stefandanila/AquariumController/CircuitSchematics_updated.png

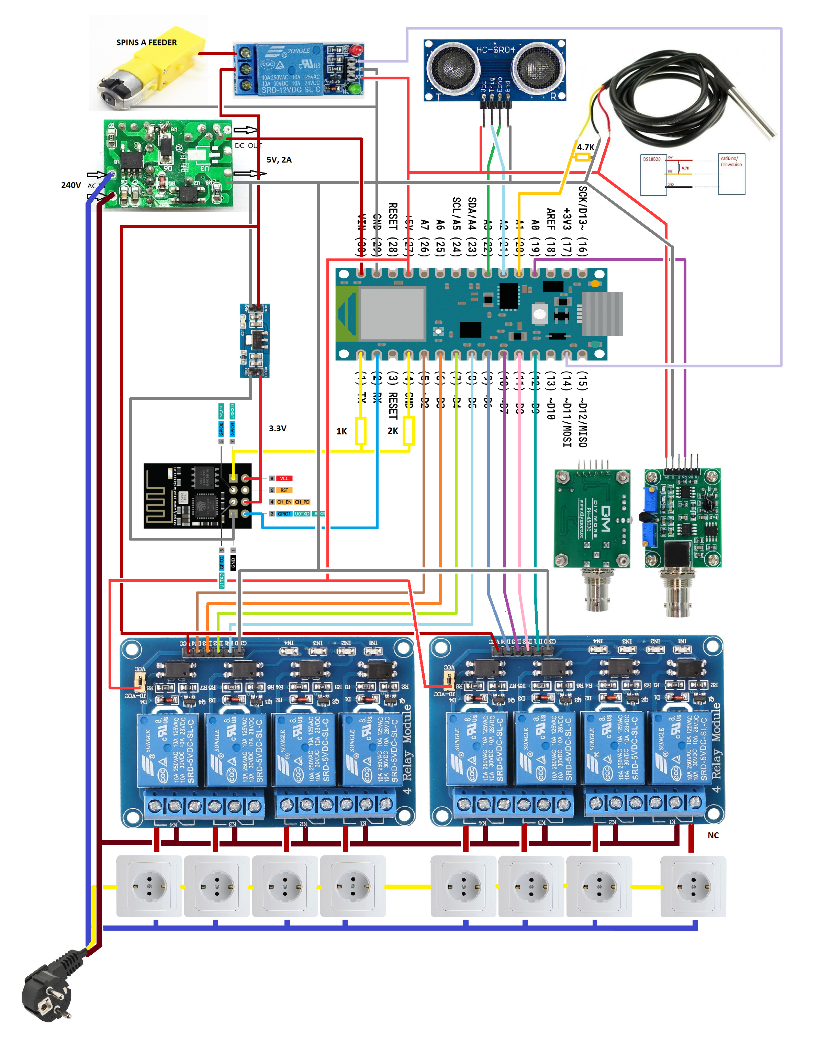
CircuitSchematics_updated.png
