stefandanila/AquariumController/HarwareExample.jpg

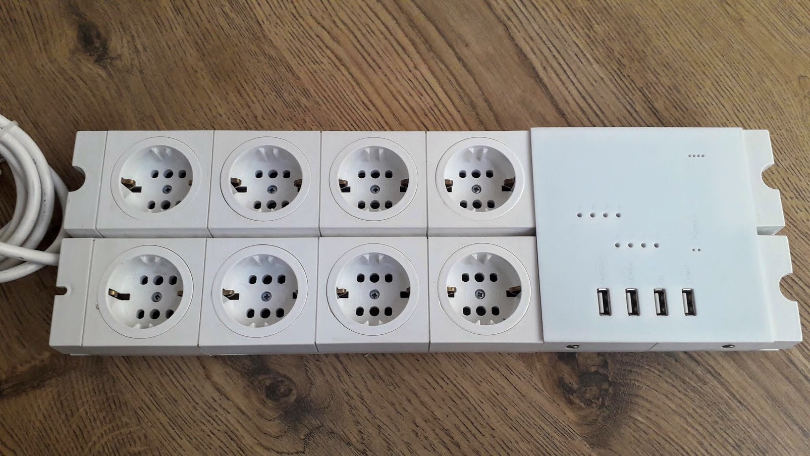
HarwareExample.jpg
