stefandanila/AquariumController/UI_Events.jpg

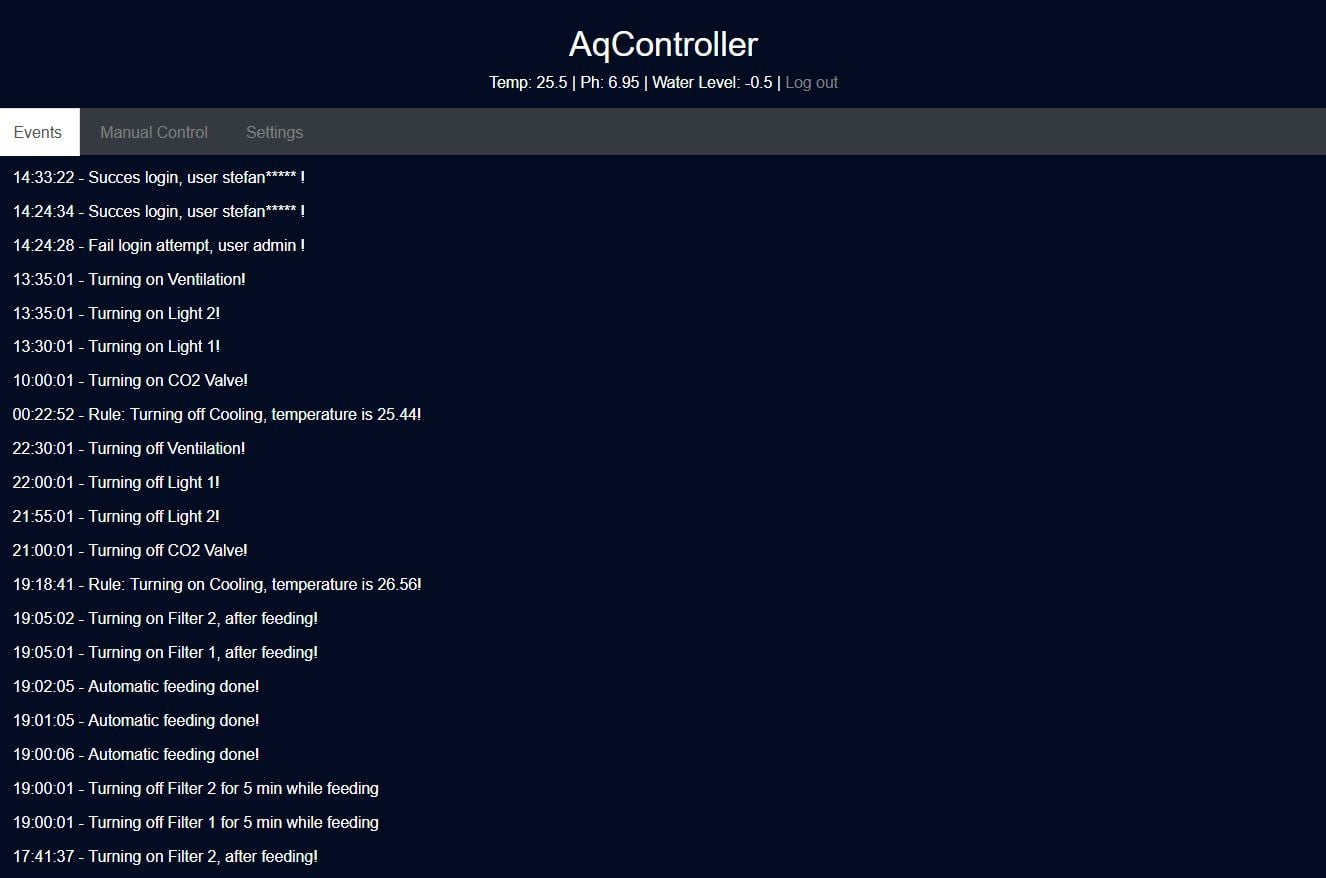
UI_Events.jpg
