stefandanila/AquariumController/UI_GeneralSettings.jpg

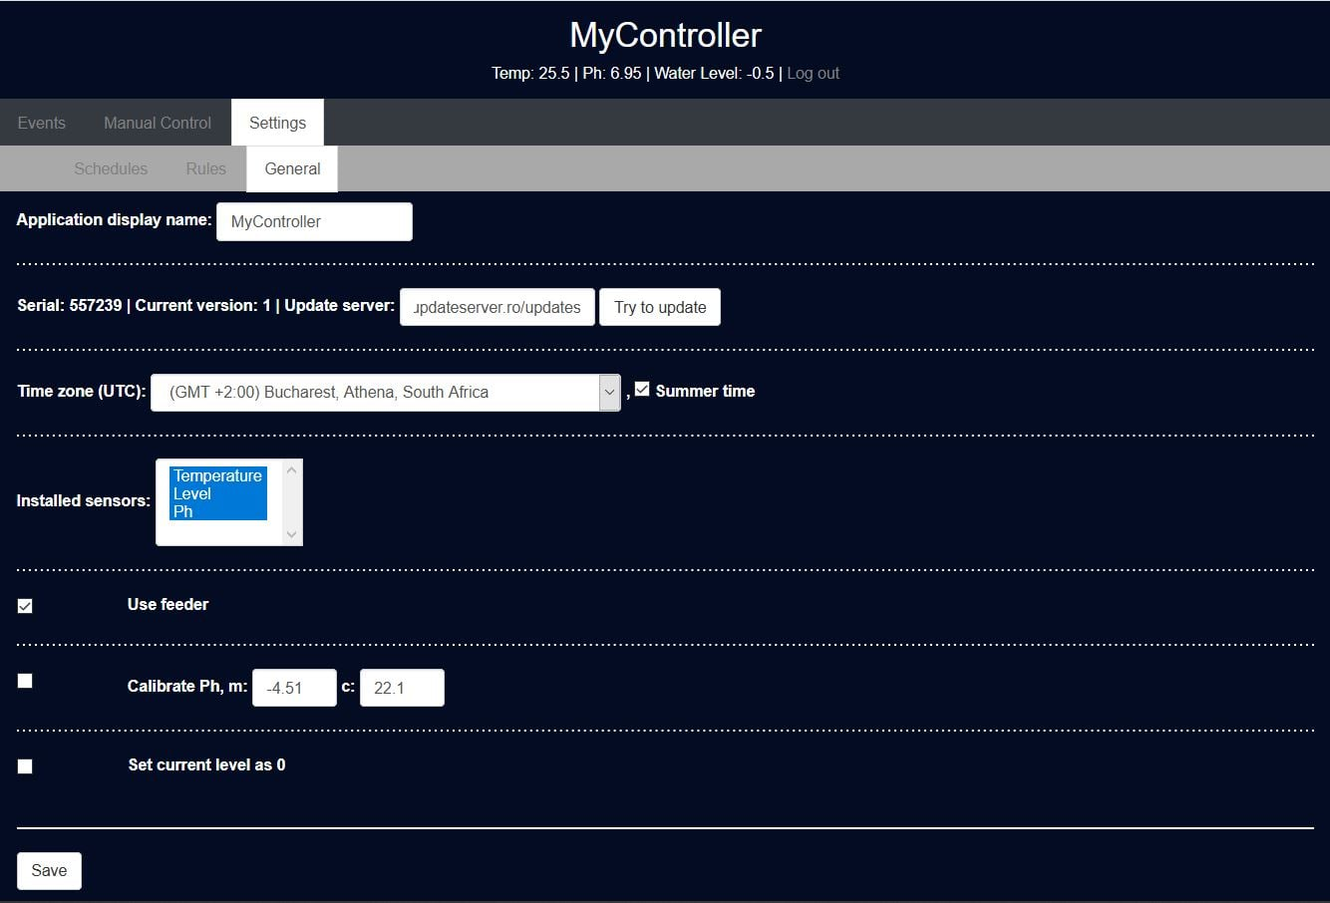
UI_GeneralSettings.jpg
