stefandanila/AquariumController/UI_Login.jpg

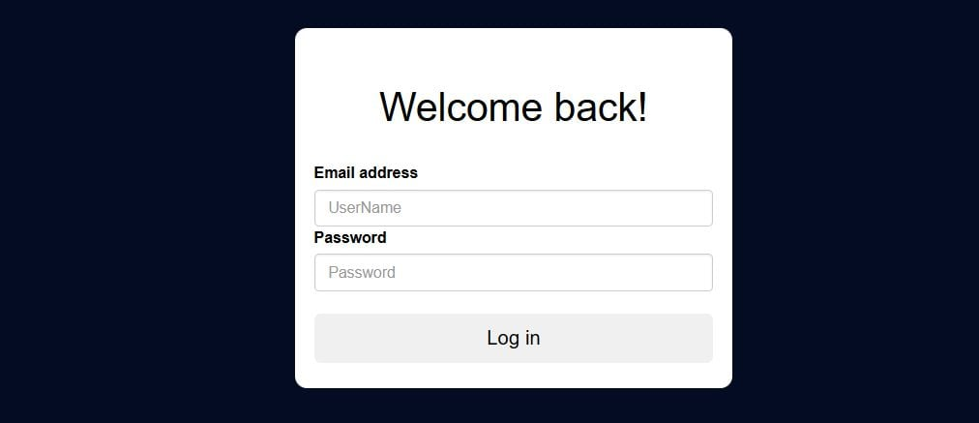
UI_Login.jpg
