stefandanila/AquariumController/UI_NetworkConf.jpg

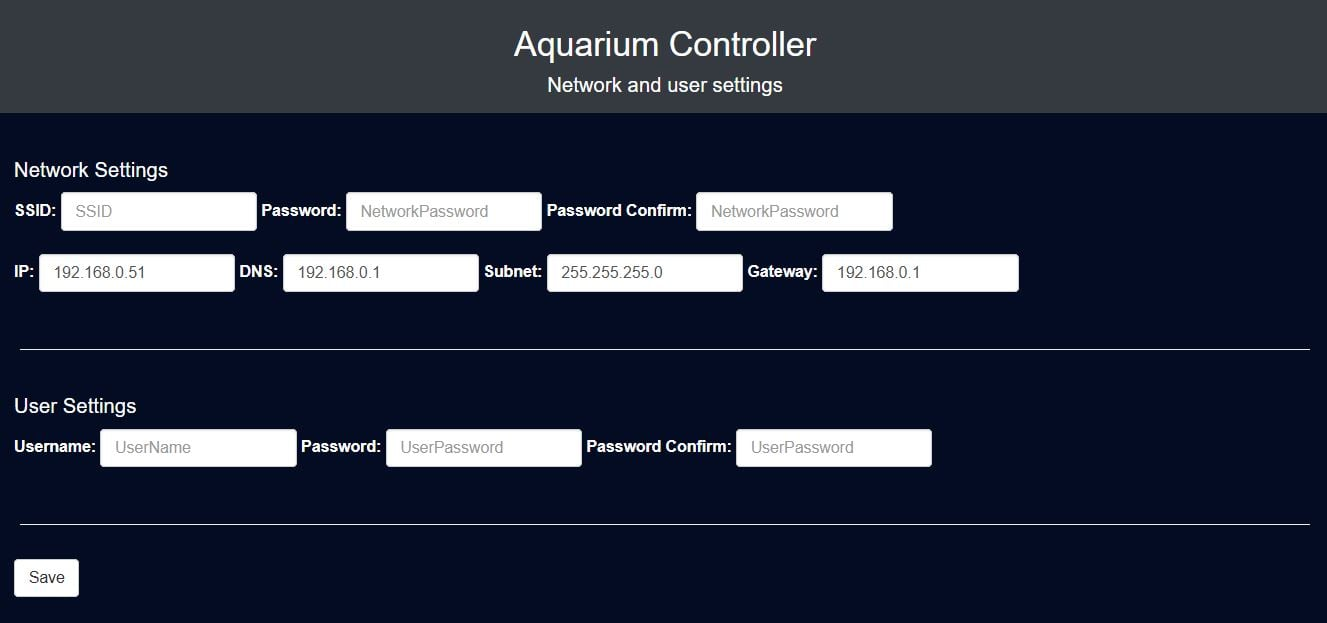
UI_NetworkConf.jpg
