stefandanila/AquariumController/UI_Rules.jpg

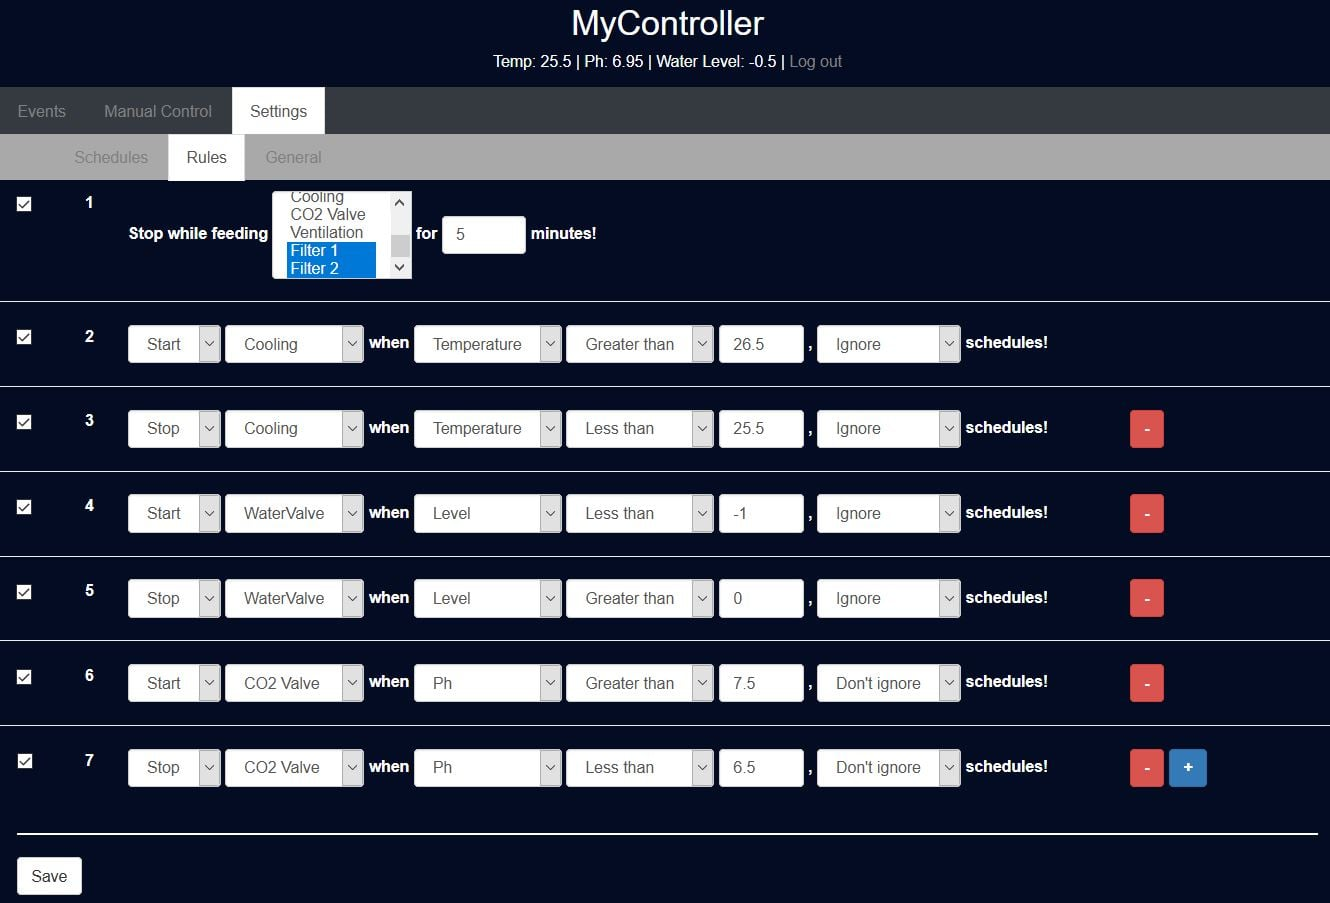
UI_Rules.jpg
