stefandanila/AquariumController/UI_Schedules.jpg

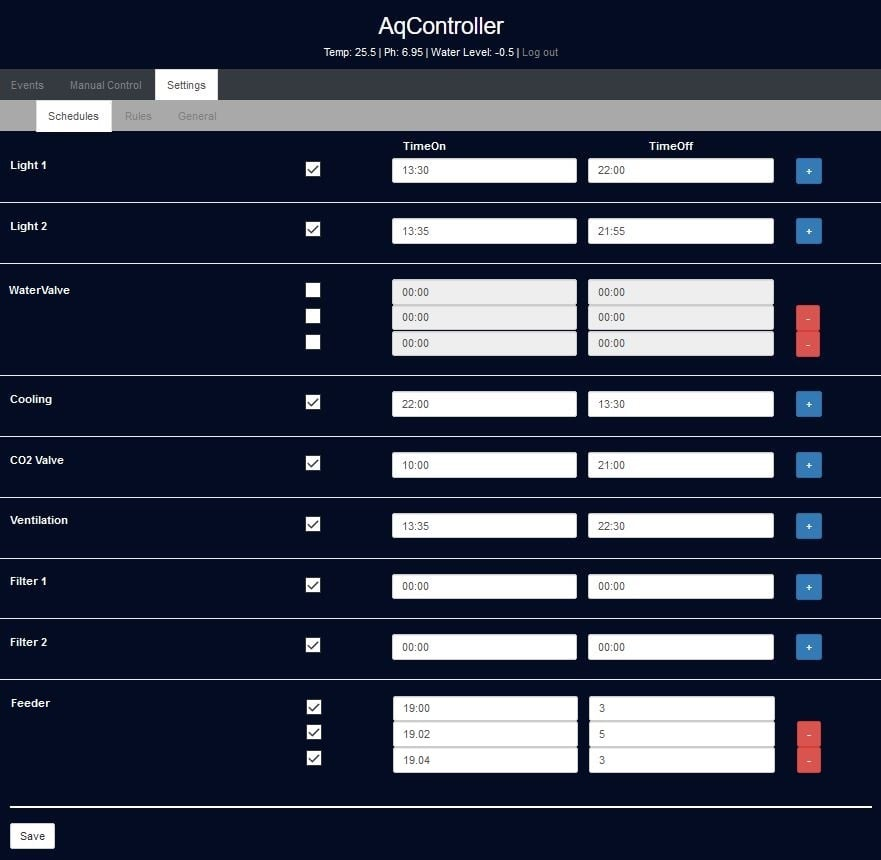
UI_Schedules.jpg
