stefandanila/AquariumController/UI_ManualControl.jpg

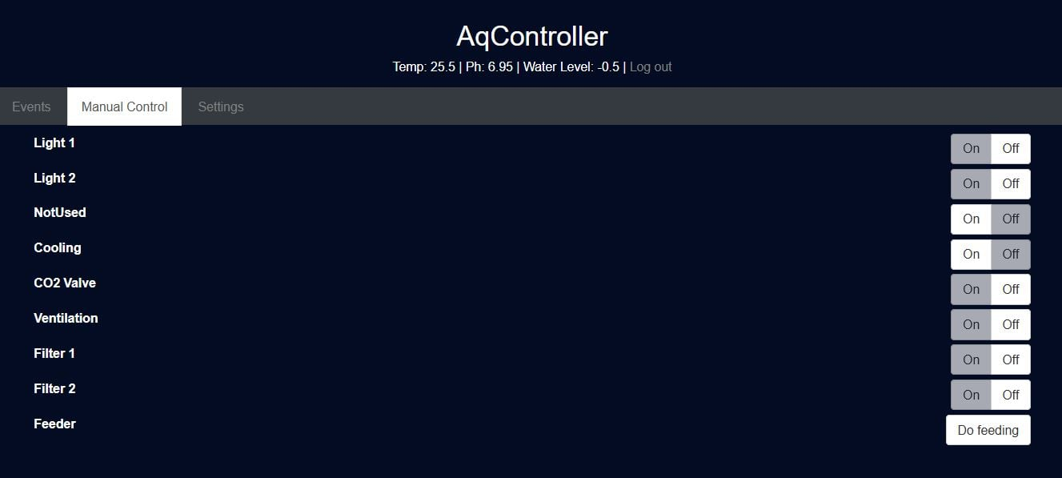
UI_ManualControl.jpg
