stefandanila/AquariumController/(commit log)

2021-02-09 Arduino Code
    This will run on Arduino, a NANO in my personal setup
2021-02-09 Create ArduinoSlave.ino
    This code will run on Arduino, in my personal setup, it runs on Nano.
2021-02-10 Circuit schematics
    The circuit schematics, more of a mockup made in ms paint.
2021-05-06 Updates
    Added username and password for webserver updates, corrected typos, added systemp state enforcer
    [ESP8266_ESP01.ino]
